garvita4/lightcube/CAD/productions/main bodyu.stl

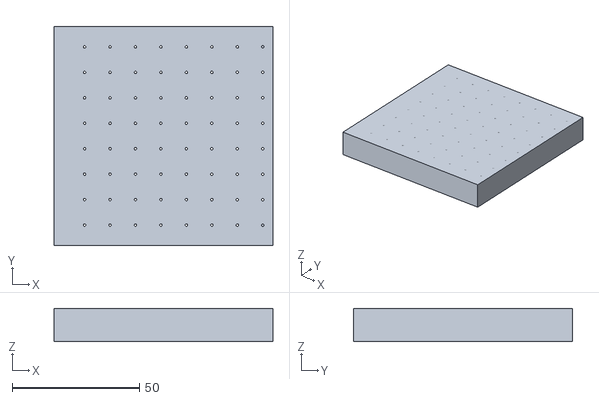
[picture p15: CAD file, 2026-11-04]
CAD/productions/main bodyu.stl
86.0 x 86.0 x 13.0
