garvita4/lightcube/CAD/design/final.stl

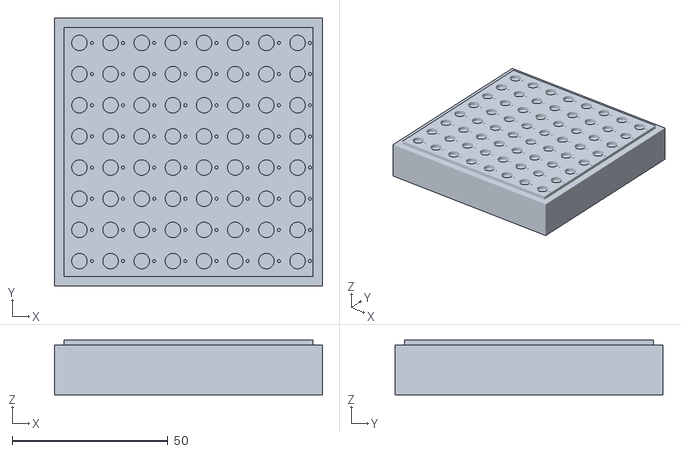
[picture p16: CAD file, 2026-11-04]
CAD/design/final.stl
86.0 x 86.0 x 17.5
