garvita4/lightcube/CAD/productions/holding plate.stl

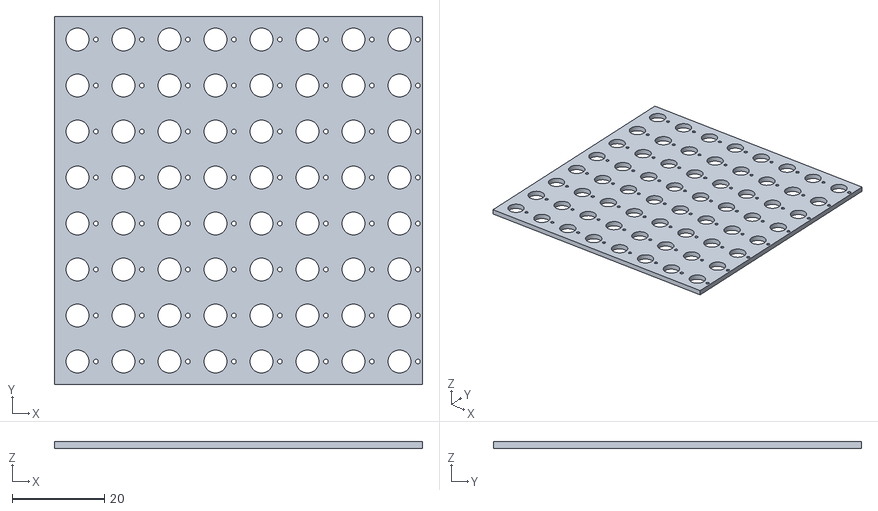
[picture p17: CAD file, 2026-11-04]
CAD/productions/holding plate.stl
80.0 x 80.0 x 1.50
