garvita4/lightcube/CAD/productions/cover.stl

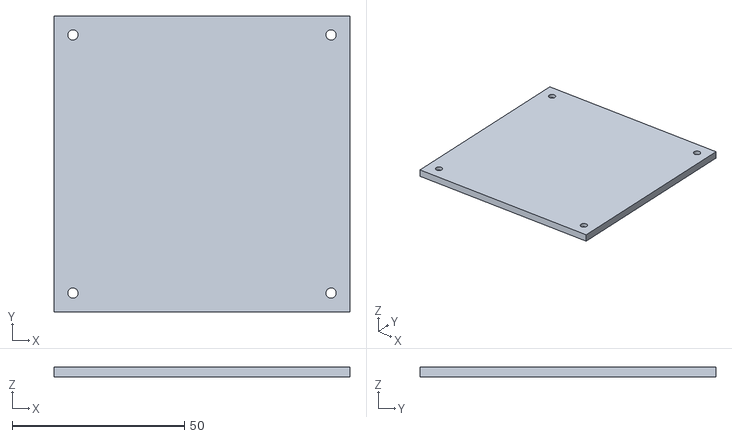
[picture p18: CAD file, 2026-11-04]
CAD/productions/cover.stl
86.0 x 86.0 x 3.00
