garvita4/lightcube/(list of files, cad)

Other CAD files:
CAD/design/final.f3d
