garvita4/lightcube/PCB/LED_L0.kicad_sch

## KiCad design PCB/LED_L0.kicad_sch (2026-11-04)

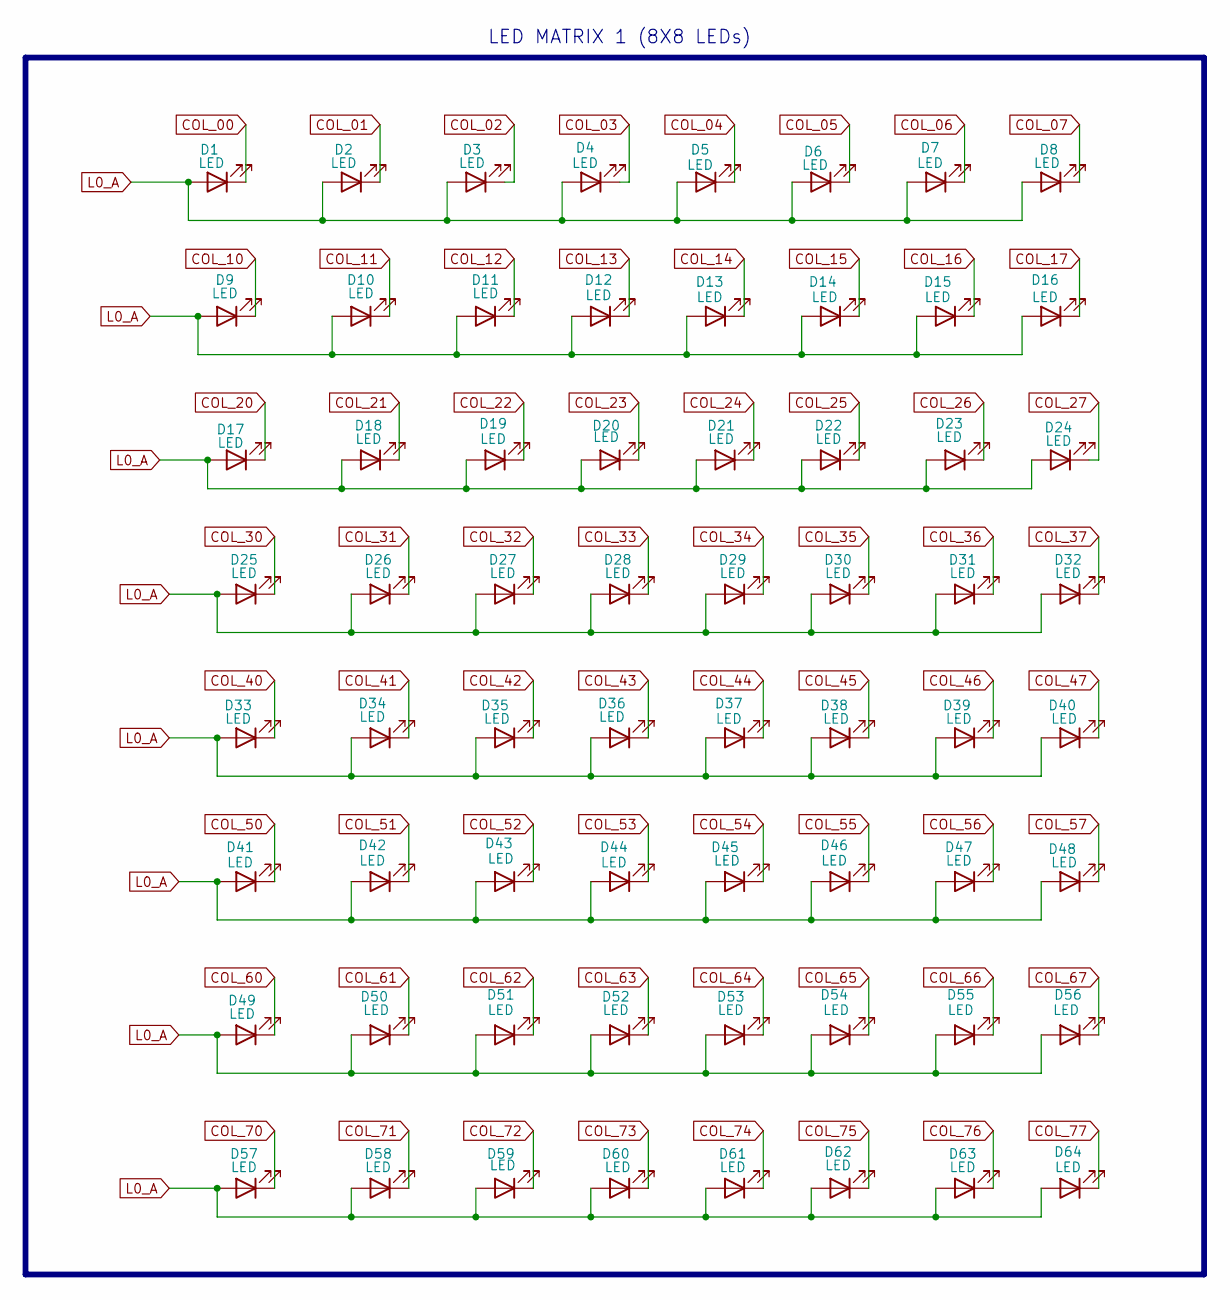
[picture p19: schematic LED_L0.kicad_sch]

Parts:
D1, D2, D3, D4, D5, D6, D7, D8, D9, D10, D11, D12, D13, D14, D15, D16, D17, D18, D19, D20, D21, D22, D23, D24, D25, D26, D27, D28, D29, D30, D31, D32, D33, D34, D35, D36, D37, D38, D39, D40, D41, D42, D43, D44, D45, D46, D47, D48, D49, D50, D51, D52, D53, D54, D55, D56, D57, D58, D59, D60, D61, D62, D63, D64: LED

Connections:
COL_00: D1.1 (K)
COL_01: D2.1 (K)
COL_02: D3.1 (K)
COL_03: D4.1 (K)
COL_04: D5.1 (K)
COL_05: D6.1 (K)
COL_06: D7.1 (K)
COL_07: D8.1 (K)
COL_10: D9.1 (K)
COL_11: D10.1 (K)
COL_12: D11.1 (K)
COL_13: D12.1 (K)
COL_14: D13.1 (K)
COL_15: D14.1 (K)
COL_16: D15.1 (K)
COL_17: D16.1 (K)
COL_20: D17.1 (K)
COL_21: D18.1 (K)
COL_22: D19.1 (K)
COL_23: D20.1 (K)
COL_24: D21.1 (K)
COL_25: D22.1 (K)
COL_26: D23.1 (K)
COL_27: D24.1 (K)
COL_30: D25.1 (K)
COL_31: D26.1 (K)
COL_32: D27.1 (K)
COL_33: D28.1 (K)
COL_34: D29.1 (K)
COL_35: D30.1 (K)
COL_36: D31.1 (K)
COL_37: D32.1 (K)
COL_40: D33.1 (K)
COL_41: D34.1 (K)
COL_42: D35.1 (K)
COL_43: D36.1 (K)
COL_44: D37.1 (K)
COL_45: D38.1 (K)
COL_46: D39.1 (K)
COL_47: D40.1 (K)
COL_50: D41.1 (K)
COL_51: D42.1 (K)
COL_52: D43.1 (K)
COL_53: D44.1 (K)
COL_54: D45.1 (K)
COL_55: D46.1 (K)
COL_56: D47.1 (K)
COL_57: D48.1 (K)
COL_60: D49.1 (K)
COL_61: D50.1 (K)
COL_62: D51.1 (K)
COL_63: D52.1 (K)
COL_64: D53.1 (K)
COL_65: D54.1 (K)
COL_66: D55.1 (K)
COL_67: D56.1 (K)
COL_70: D57.1 (K)
COL_71: D58.1 (K)
COL_72: D59.1 (K)
COL_73: D60.1 (K)
COL_74: D61.1 (K)
COL_75: D62.1 (K)
COL_76: D63.1 (K)
COL_77: D64.1 (K)
L0_A: D1.2 (A), D2.2 (A), D3.2 (A), D4.2 (A), D5.2 (A), D6.2 (A), D7.2 (A), D8.2 (A), D9.2 (A), D10.2 (A), D11.2 (A), D12.2 (A), D13.2 (A), D14.2 (A), D15.2 (A), D16.2 (A), D17.2 (A), D18.2 (A), D19.2 (A), D20.2 (A), D21.2 (A), D22.2 (A), D23.2 (A), D24.2 (A), D25.2 (A), D26.2 (A), D27.2 (A), D28.2 (A), D29.2 (A), D30.2 (A), D31.2 (A), D32.2 (A), D33.2 (A), D34.2 (A), D35.2 (A), D36.2 (A), D37.2 (A), D38.2 (A), D39.2 (A), D40.2 (A), D41.2 (A), D42.2 (A), D43.2 (A), D44.2 (A), D45.2 (A), D46.2 (A), D47.2 (A), D48.2 (A), D49.2 (A), D50.2 (A), D51.2 (A), D52.2 (A), D53.2 (A), D54.2 (A), D55.2 (A), D56.2 (A), D57.2 (A), D58.2 (A), D59.2 (A), D60.2 (A), D61.2 (A), D62.2 (A), D63.2 (A), D64.2 (A)

Notes on the sheet:
LED MATRIX 1 (8X8 LEDs)
