garvita4/lightcube/PCB/LED_L1.kicad_sch

## KiCad design PCB/LED_L1.kicad_sch (2026-11-11)

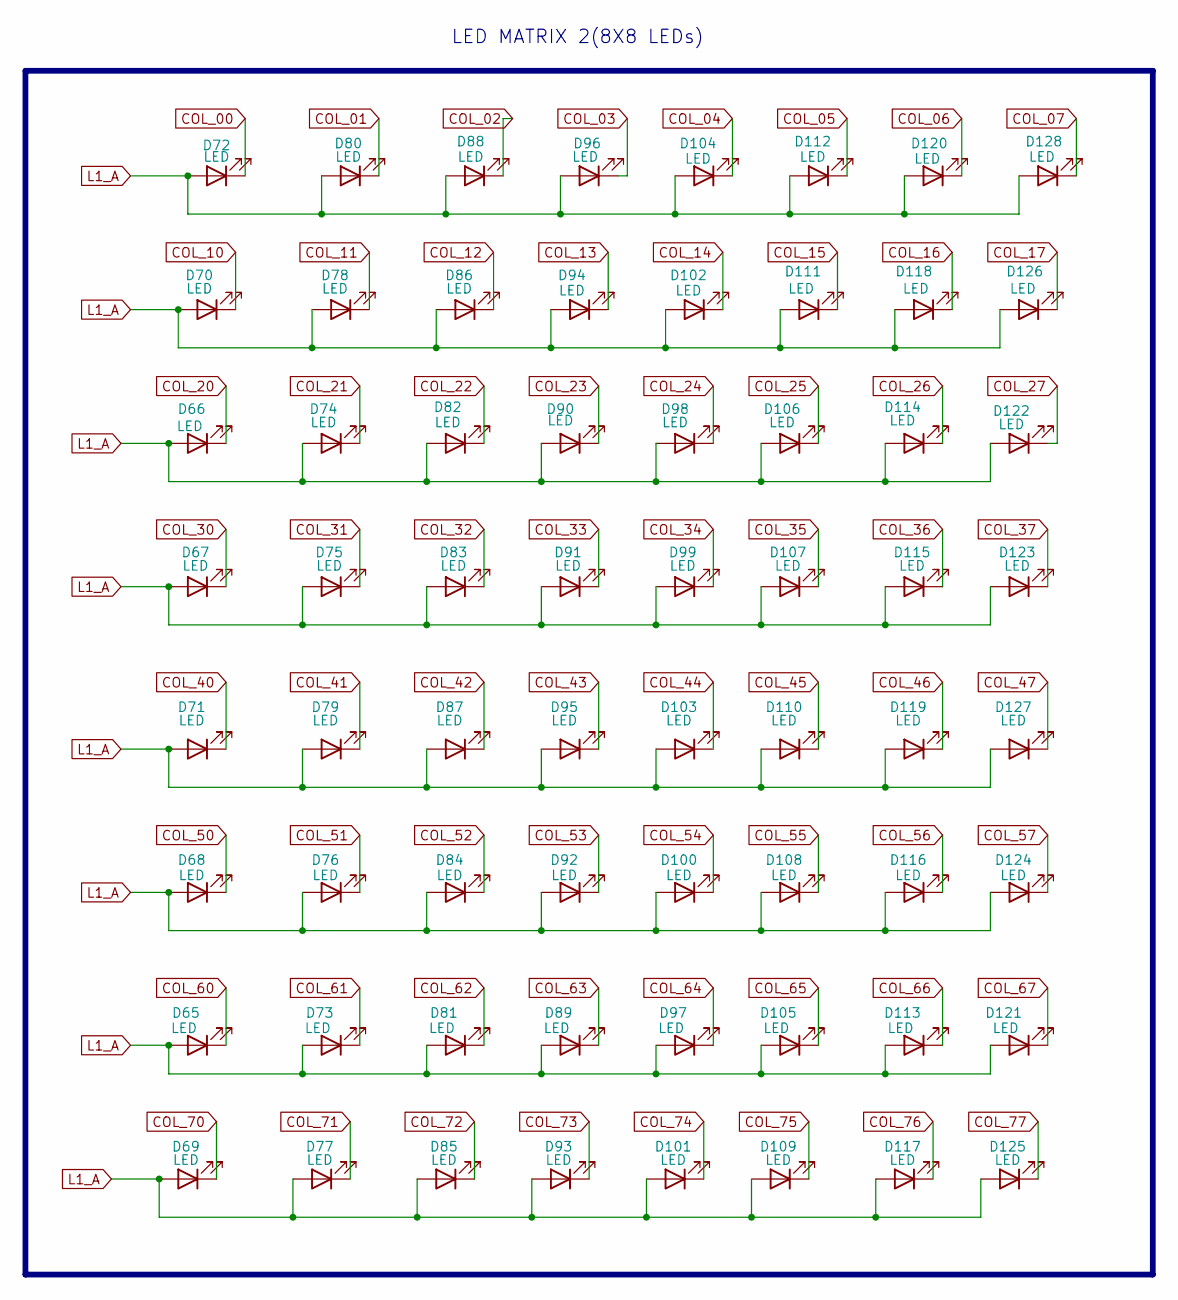
[picture p20: schematic LED_L1.kicad_sch]

Parts:
D65, D66, D67, D68, D69, D70, D71, D72, D73, D74, D75, D76, D77, D78, D79, D80, D81, D82, D83, D84, D85, D86, D87, D88, D89, D90, D91, D92, D93, D94, D95, D96, D97, D98, D99, D100, D101, D102, D103, D104, D105, D106, D107, D108, D109, D110, D111, D112, D113, D114, D115, D116, D117, D118, D119, D120, D121, D122, D123, D124, D125, D126, D127, D128: LED

Connections:
COL_00: D72.1 (K)
COL_01: D80.1 (K)
COL_02: D88.1 (K)
COL_03: D96.1 (K)
COL_04: D104.1 (K)
COL_05: D112.1 (K)
COL_06: D120.1 (K)
COL_07: D128.1 (K)
COL_10: D70.1 (K)
COL_11: D78.1 (K)
COL_12: D86.1 (K)
COL_13: D94.1 (K)
COL_14: D102.1 (K)
COL_15: D111.1 (K)
COL_16: D118.1 (K)
COL_17: D126.1 (K)
COL_20: D66.1 (K)
COL_21: D74.1 (K)
COL_22: D82.1 (K)
COL_23: D90.1 (K)
COL_24: D98.1 (K)
COL_25: D106.1 (K)
COL_26: D114.1 (K)
COL_27: D122.1 (K)
COL_30: D67.1 (K)
COL_31: D75.1 (K)
COL_32: D83.1 (K)
COL_33: D91.1 (K)
COL_34: D99.1 (K)
COL_35: D107.1 (K)
COL_36: D115.1 (K)
COL_37: D123.1 (K)
COL_40: D71.1 (K)
COL_41: D79.1 (K)
COL_42: D87.1 (K)
COL_43: D95.1 (K)
COL_44: D103.1 (K)
COL_45: D110.1 (K)
COL_46: D119.1 (K)
COL_47: D127.1 (K)
COL_50: D68.1 (K)
COL_51: D76.1 (K)
COL_52: D84.1 (K)
COL_53: D92.1 (K)
COL_54: D100.1 (K)
COL_55: D108.1 (K)
COL_56: D116.1 (K)
COL_57: D124.1 (K)
COL_60: D65.1 (K)
COL_61: D73.1 (K)
COL_62: D81.1 (K)
COL_63: D89.1 (K)
COL_64: D97.1 (K)
COL_65: D105.1 (K)
COL_66: D113.1 (K)
COL_67: D121.1 (K)
COL_70: D69.1 (K)
COL_71: D77.1 (K)
COL_72: D85.1 (K)
COL_73: D93.1 (K)
COL_74: D101.1 (K)
COL_75: D109.1 (K)
COL_76: D117.1 (K)
COL_77: D125.1 (K)
L1_A: D65.2 (A), D66.2 (A), D67.2 (A), D68.2 (A), D69.2 (A), D70.2 (A), D71.2 (A), D72.2 (A), D73.2 (A), D74.2 (A), D75.2 (A), D76.2 (A), D77.2 (A), D78.2 (A), D79.2 (A), D80.2 (A), D81.2 (A), D82.2 (A), D83.2 (A), D84.2 (A), D85.2 (A), D86.2 (A), D87.2 (A), D88.2 (A), D89.2 (A), D90.2 (A), D91.2 (A), D92.2 (A), D93.2 (A), D94.2 (A), D95.2 (A), D96.2 (A), D97.2 (A), D98.2 (A), D99.2 (A), D100.2 (A), D101.2 (A), D102.2 (A), D103.2 (A), D104.2 (A), D105.2 (A), D106.2 (A), D107.2 (A), D108.2 (A), D109.2 (A), D110.2 (A), D111.2 (A), D112.2 (A), D113.2 (A), D114.2 (A), D115.2 (A), D116.2 (A), D117.2 (A), D118.2 (A), D119.2 (A), D120.2 (A), D121.2 (A), D122.2 (A), D123.2 (A), D124.2 (A), D125.2 (A), D126.2 (A), D127.2 (A), D128.2 (A)

Notes on the sheet:
LED MATRIX 2(8X8 LEDs)
