garvita4/lightcube/PCB/LED_L2.kicad_sch

## KiCad design PCB/LED_L2.kicad_sch (2026-11-11)

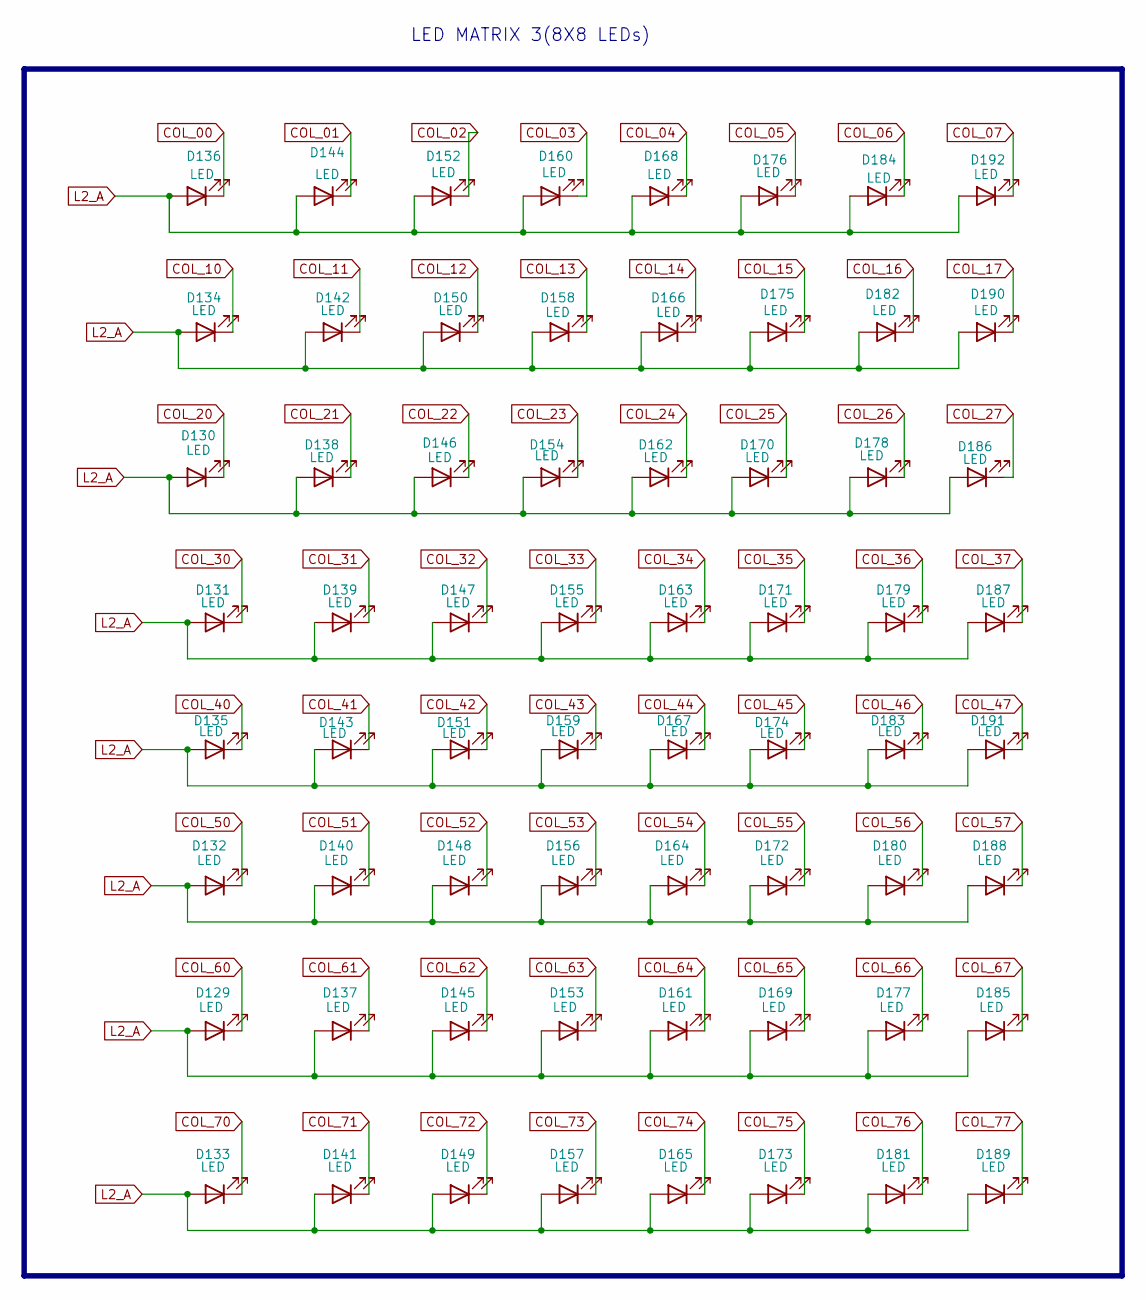
[picture p21: schematic LED_L2.kicad_sch]

Parts:
D129, D130, D131, D132, D133, D134, D135, D136, D137, D138, D139, D140, D141, D142, D143, D144, D145, D146, D147, D148, D149, D150, D151, D152, D153, D154, D155, D156, D157, D158, D159, D160, D161, D162, D163, D164, D165, D166, D167, D168, D169, D170, D171, D172, D173, D174, D175, D176, D177, D178, D179, D180, D181, D182, D183, D184, D185, D186, D187, D188, D189, D190, D191, D192: LED

Connections:
COL_00: D136.1 (K)
COL_01: D144.1 (K)
COL_02: D152.1 (K)
COL_03: D160.1 (K)
COL_04: D168.1 (K)
COL_05: D176.1 (K)
COL_06: D184.1 (K)
COL_07: D192.1 (K)
COL_10: D134.1 (K)
COL_11: D142.1 (K)
COL_12: D150.1 (K)
COL_13: D158.1 (K)
COL_14: D166.1 (K)
COL_15: D175.1 (K)
COL_16: D182.1 (K)
COL_17: D190.1 (K)
COL_20: D130.1 (K)
COL_21: D138.1 (K)
COL_22: D146.1 (K)
COL_23: D154.1 (K)
COL_24: D162.1 (K)
COL_25: D170.1 (K)
COL_26: D178.1 (K)
COL_27: D186.1 (K)
COL_30: D131.1 (K)
COL_31: D139.1 (K)
COL_32: D147.1 (K)
COL_33: D155.1 (K)
COL_34: D163.1 (K)
COL_35: D171.1 (K)
COL_36: D179.1 (K)
COL_37: D187.1 (K)
COL_40: D135.1 (K)
COL_41: D143.1 (K)
COL_42: D151.1 (K)
COL_43: D159.1 (K)
COL_44: D167.1 (K)
COL_45: D174.1 (K)
COL_46: D183.1 (K)
COL_47: D191.1 (K)
COL_50: D132.1 (K)
COL_51: D140.1 (K)
COL_52: D148.1 (K)
COL_53: D156.1 (K)
COL_54: D164.1 (K)
COL_55: D172.1 (K)
COL_56: D180.1 (K)
COL_57: D188.1 (K)
COL_60: D129.1 (K)
COL_61: D137.1 (K)
COL_62: D145.1 (K)
COL_63: D153.1 (K)
COL_64: D161.1 (K)
COL_65: D169.1 (K)
COL_66: D177.1 (K)
COL_67: D185.1 (K)
COL_70: D133.1 (K)
COL_71: D141.1 (K)
COL_72: D149.1 (K)
COL_73: D157.1 (K)
COL_74: D165.1 (K)
COL_75: D173.1 (K)
COL_76: D181.1 (K)
COL_77: D189.1 (K)
L2_A: D129.2 (A), D130.2 (A), D131.2 (A), D132.2 (A), D133.2 (A), D134.2 (A), D135.2 (A), D136.2 (A), D137.2 (A), D138.2 (A), D139.2 (A), D140.2 (A), D141.2 (A), D142.2 (A), D143.2 (A), D144.2 (A), D145.2 (A), D146.2 (A), D147.2 (A), D148.2 (A), D149.2 (A), D150.2 (A), D151.2 (A), D152.2 (A), D153.2 (A), D154.2 (A), D155.2 (A), D156.2 (A), D157.2 (A), D158.2 (A), D159.2 (A), D160.2 (A), D161.2 (A), D162.2 (A), D163.2 (A), D164.2 (A), D165.2 (A), D166.2 (A), D167.2 (A), D168.2 (A), D169.2 (A), D170.2 (A), D171.2 (A), D172.2 (A), D173.2 (A), D174.2 (A), D175.2 (A), D176.2 (A), D177.2 (A), D178.2 (A), D179.2 (A), D180.2 (A), D181.2 (A), D182.2 (A), D183.2 (A), D184.2 (A), D185.2 (A), D186.2 (A), D187.2 (A), D188.2 (A), D189.2 (A), D190.2 (A), D191.2 (A), D192.2 (A)

Notes on the sheet:
LED MATRIX 3(8X8 LEDs)
