garvita4/lightcube/PCB/LED_L3.kicad_sch

## KiCad design PCB/LED_L3.kicad_sch (2026-11-11)

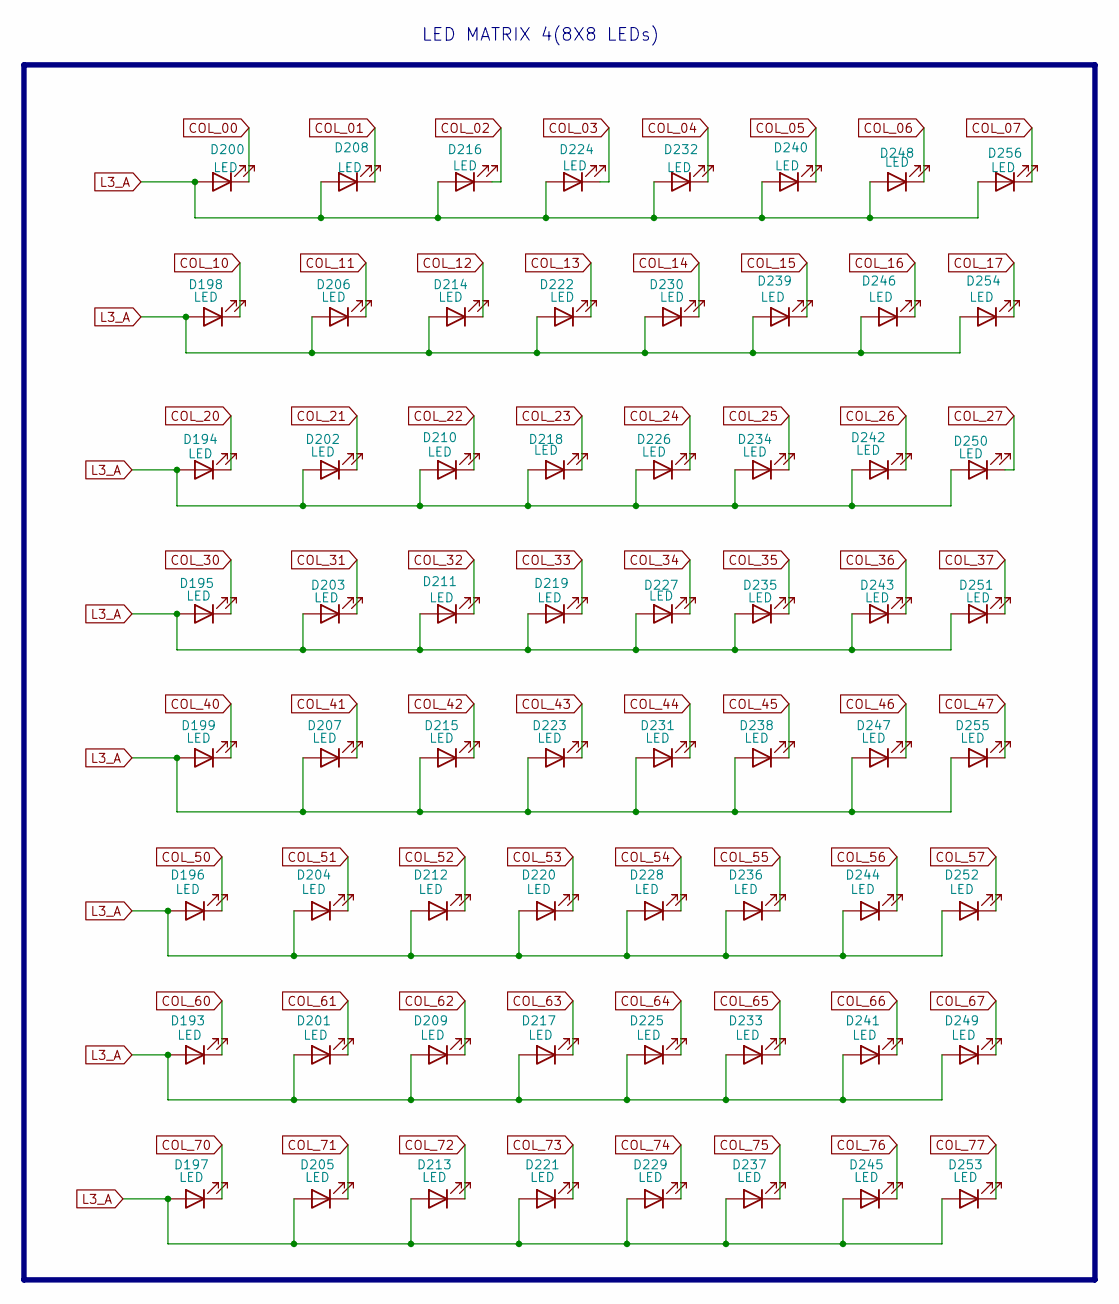
[picture p22: schematic LED_L3.kicad_sch]

Parts:
D193, D194, D195, D196, D197, D198, D199, D200, D201, D202, D203, D204, D205, D206, D207, D208, D209, D210, D211, D212, D213, D214, D215, D216, D217, D218, D219, D220, D221, D222, D223, D224, D225, D226, D227, D228, D229, D230, D231, D232, D233, D234, D235, D236, D237, D238, D239, D240, D241, D242, D243, D244, D245, D246, D247, D248, D249, D250, D251, D252, D253, D254, D255, D256: LED

Connections:
COL_00: D200.1 (K)
COL_01: D208.1 (K)
COL_02: D216.1 (K)
COL_03: D224.1 (K)
COL_04: D232.1 (K)
COL_05: D240.1 (K)
COL_06: D248.1 (K)
COL_07: D256.1 (K)
COL_10: D198.1 (K)
COL_11: D206.1 (K)
COL_12: D214.1 (K)
COL_13: D222.1 (K)
COL_14: D230.1 (K)
COL_15: D239.1 (K)
COL_16: D246.1 (K)
COL_17: D254.1 (K)
COL_20: D194.1 (K)
COL_21: D202.1 (K)
COL_22: D210.1 (K)
COL_23: D218.1 (K)
COL_24: D226.1 (K)
COL_25: D234.1 (K)
COL_26: D242.1 (K)
COL_27: D250.1 (K)
COL_30: D195.1 (K)
COL_31: D203.1 (K)
COL_32: D211.1 (K)
COL_33: D219.1 (K)
COL_34: D227.1 (K)
COL_35: D235.1 (K)
COL_36: D243.1 (K)
COL_37: D251.1 (K)
COL_40: D199.1 (K)
COL_41: D207.1 (K)
COL_42: D215.1 (K)
COL_43: D223.1 (K)
COL_44: D231.1 (K)
COL_45: D238.1 (K)
COL_46: D247.1 (K)
COL_47: D255.1 (K)
COL_50: D196.1 (K)
COL_51: D204.1 (K)
COL_52: D212.1 (K)
COL_53: D220.1 (K)
COL_54: D228.1 (K)
COL_55: D236.1 (K)
COL_56: D244.1 (K)
COL_57: D252.1 (K)
COL_60: D193.1 (K)
COL_61: D201.1 (K)
COL_62: D209.1 (K)
COL_63: D217.1 (K)
COL_64: D225.1 (K)
COL_65: D233.1 (K)
COL_66: D241.1 (K)
COL_67: D249.1 (K)
COL_70: D197.1 (K)
COL_71: D205.1 (K)
COL_72: D213.1 (K)
COL_73: D221.1 (K)
COL_74: D229.1 (K)
COL_75: D237.1 (K)
COL_76: D245.1 (K)
COL_77: D253.1 (K)
L3_A: D193.2 (A), D194.2 (A), D195.2 (A), D196.2 (A), D197.2 (A), D198.2 (A), D199.2 (A), D200.2 (A), D201.2 (A), D202.2 (A), D203.2 (A), D204.2 (A), D205.2 (A), D206.2 (A), D207.2 (A), D208.2 (A), D209.2 (A), D210.2 (A), D211.2 (A), D212.2 (A), D213.2 (A), D214.2 (A), D215.2 (A), D216.2 (A), D217.2 (A), D218.2 (A), D219.2 (A), D220.2 (A), D221.2 (A), D222.2 (A), D223.2 (A), D224.2 (A), D225.2 (A), D226.2 (A), D227.2 (A), D228.2 (A), D229.2 (A), D230.2 (A), D231.2 (A), D232.2 (A), D233.2 (A), D234.2 (A), D235.2 (A), D236.2 (A), D237.2 (A), D238.2 (A), D239.2 (A), D240.2 (A), D241.2 (A), D242.2 (A), D243.2 (A), D244.2 (A), D245.2 (A), D246.2 (A), D247.2 (A), D248.2 (A), D249.2 (A), D250.2 (A), D251.2 (A), D252.2 (A), D253.2 (A), D254.2 (A), D255.2 (A), D256.2 (A)

Notes on the sheet:
LED MATRIX 4(8X8 LEDs)
