garvita4/lightcube/PCB/LED_L4.kicad_sch

## KiCad design PCB/LED_L4.kicad_sch (2026-11-11)

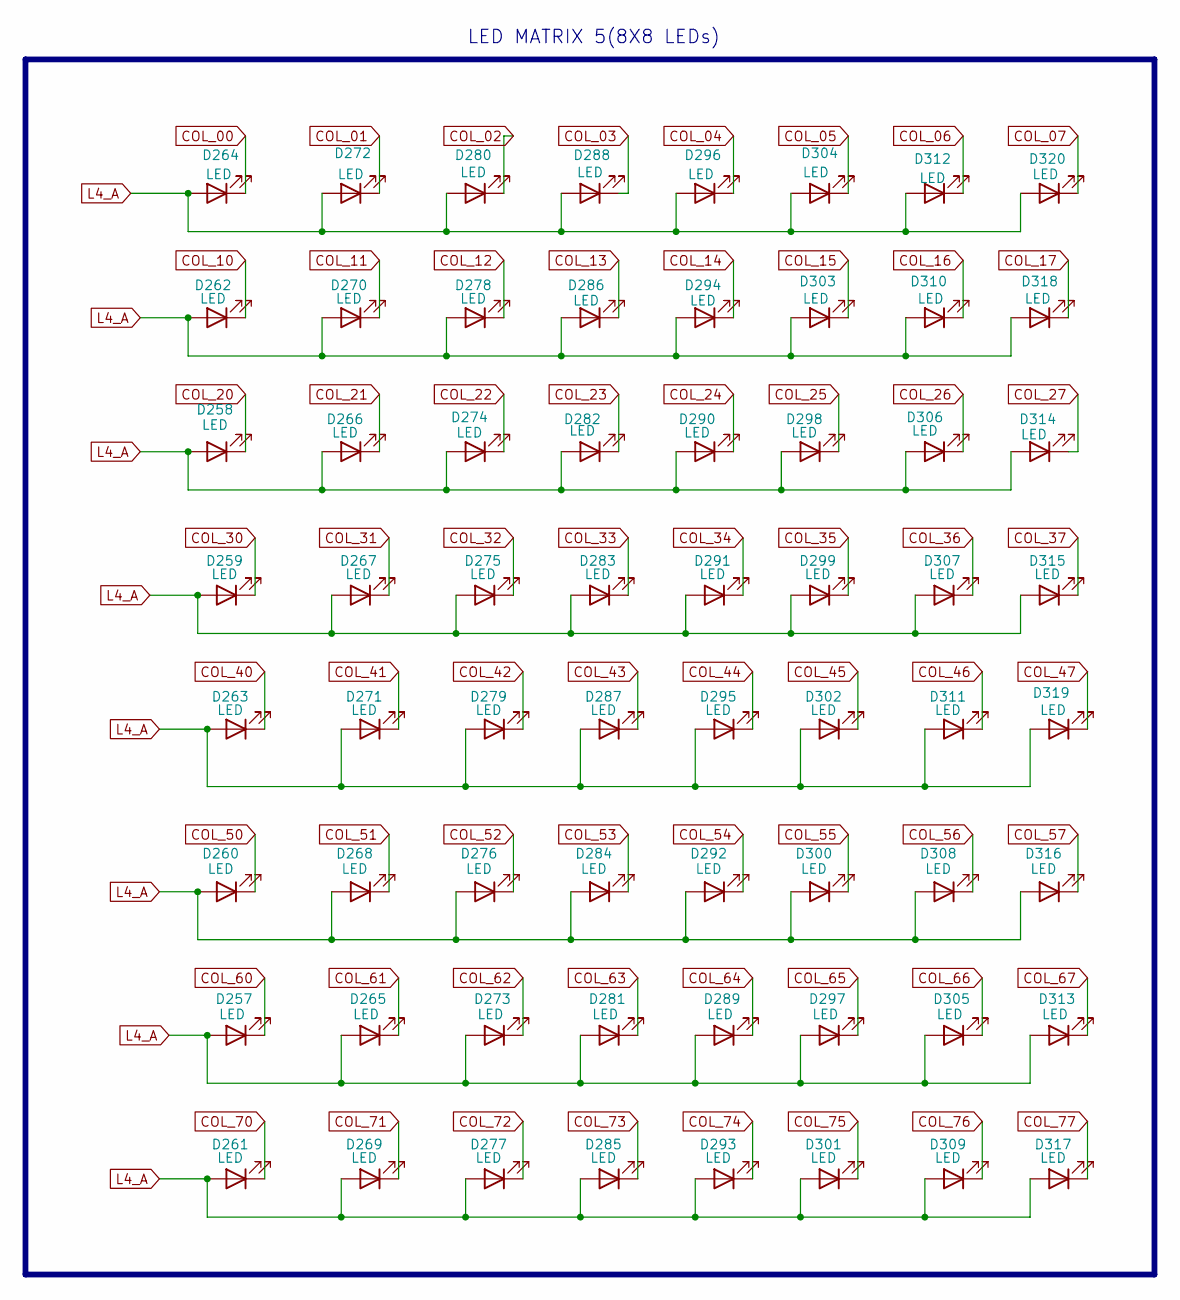
[picture p23: schematic LED_L4.kicad_sch]

Parts:
D257, D258, D259, D260, D261, D262, D263, D264, D265, D266, D267, D268, D269, D270, D271, D272, D273, D274, D275, D276, D277, D278, D279, D280, D281, D282, D283, D284, D285, D286, D287, D288, D289, D290, D291, D292, D293, D294, D295, D296, D297, D298, D299, D300, D301, D302, D303, D304, D305, D306, D307, D308, D309, D310, D311, D312, D313, D314, D315, D316, D317, D318, D319, D320: LED

Connections:
COL_00: D264.1 (K)
COL_01: D272.1 (K)
COL_02: D280.1 (K)
COL_03: D288.1 (K)
COL_04: D296.1 (K)
COL_05: D304.1 (K)
COL_06: D312.1 (K)
COL_07: D320.1 (K)
COL_10: D262.1 (K)
COL_11: D270.1 (K)
COL_12: D278.1 (K)
COL_13: D286.1 (K)
COL_14: D294.1 (K)
COL_15: D303.1 (K)
COL_16: D310.1 (K)
COL_17: D318.1 (K)
COL_20: D258.1 (K)
COL_21: D266.1 (K)
COL_22: D274.1 (K)
COL_23: D282.1 (K)
COL_24: D290.1 (K)
COL_25: D298.1 (K)
COL_26: D306.1 (K)
COL_27: D314.1 (K)
COL_30: D259.1 (K)
COL_31: D267.1 (K)
COL_32: D275.1 (K)
COL_33: D283.1 (K)
COL_34: D291.1 (K)
COL_35: D299.1 (K)
COL_36: D307.1 (K)
COL_37: D315.1 (K)
COL_40: D263.1 (K)
COL_41: D271.1 (K)
COL_42: D279.1 (K)
COL_43: D287.1 (K)
COL_44: D295.1 (K)
COL_45: D302.1 (K)
COL_46: D311.1 (K)
COL_47: D319.1 (K)
COL_50: D260.1 (K)
COL_51: D268.1 (K)
COL_52: D276.1 (K)
COL_53: D284.1 (K)
COL_54: D292.1 (K)
COL_55: D300.1 (K)
COL_56: D308.1 (K)
COL_57: D316.1 (K)
COL_60: D257.1 (K)
COL_61: D265.1 (K)
COL_62: D273.1 (K)
COL_63: D281.1 (K)
COL_64: D289.1 (K)
COL_65: D297.1 (K)
COL_66: D305.1 (K)
COL_67: D313.1 (K)
COL_70: D261.1 (K)
COL_71: D269.1 (K)
COL_72: D277.1 (K)
COL_73: D285.1 (K)
COL_74: D293.1 (K)
COL_75: D301.1 (K)
COL_76: D309.1 (K)
COL_77: D317.1 (K)
L4_A: D257.2 (A), D258.2 (A), D259.2 (A), D260.2 (A), D261.2 (A), D262.2 (A), D263.2 (A), D264.2 (A), D265.2 (A), D266.2 (A), D267.2 (A), D268.2 (A), D269.2 (A), D270.2 (A), D271.2 (A), D272.2 (A), D273.2 (A), D274.2 (A), D275.2 (A), D276.2 (A), D277.2 (A), D278.2 (A), D279.2 (A), D280.2 (A), D281.2 (A), D282.2 (A), D283.2 (A), D284.2 (A), D285.2 (A), D286.2 (A), D287.2 (A), D288.2 (A), D289.2 (A), D290.2 (A), D291.2 (A), D292.2 (A), D293.2 (A), D294.2 (A), D295.2 (A), D296.2 (A), D297.2 (A), D298.2 (A), D299.2 (A), D300.2 (A), D301.2 (A), D302.2 (A), D303.2 (A), D304.2 (A), D305.2 (A), D306.2 (A), D307.2 (A), D308.2 (A), D309.2 (A), D310.2 (A), D311.2 (A), D312.2 (A), D313.2 (A), D314.2 (A), D315.2 (A), D316.2 (A), D317.2 (A), D318.2 (A), D319.2 (A), D320.2 (A)

Notes on the sheet:
LED MATRIX 5(8X8 LEDs)
