garvita4/lightcube/PCB/LED_L5.kicad_sch

## KiCad design PCB/LED_L5.kicad_sch (2026-11-11)

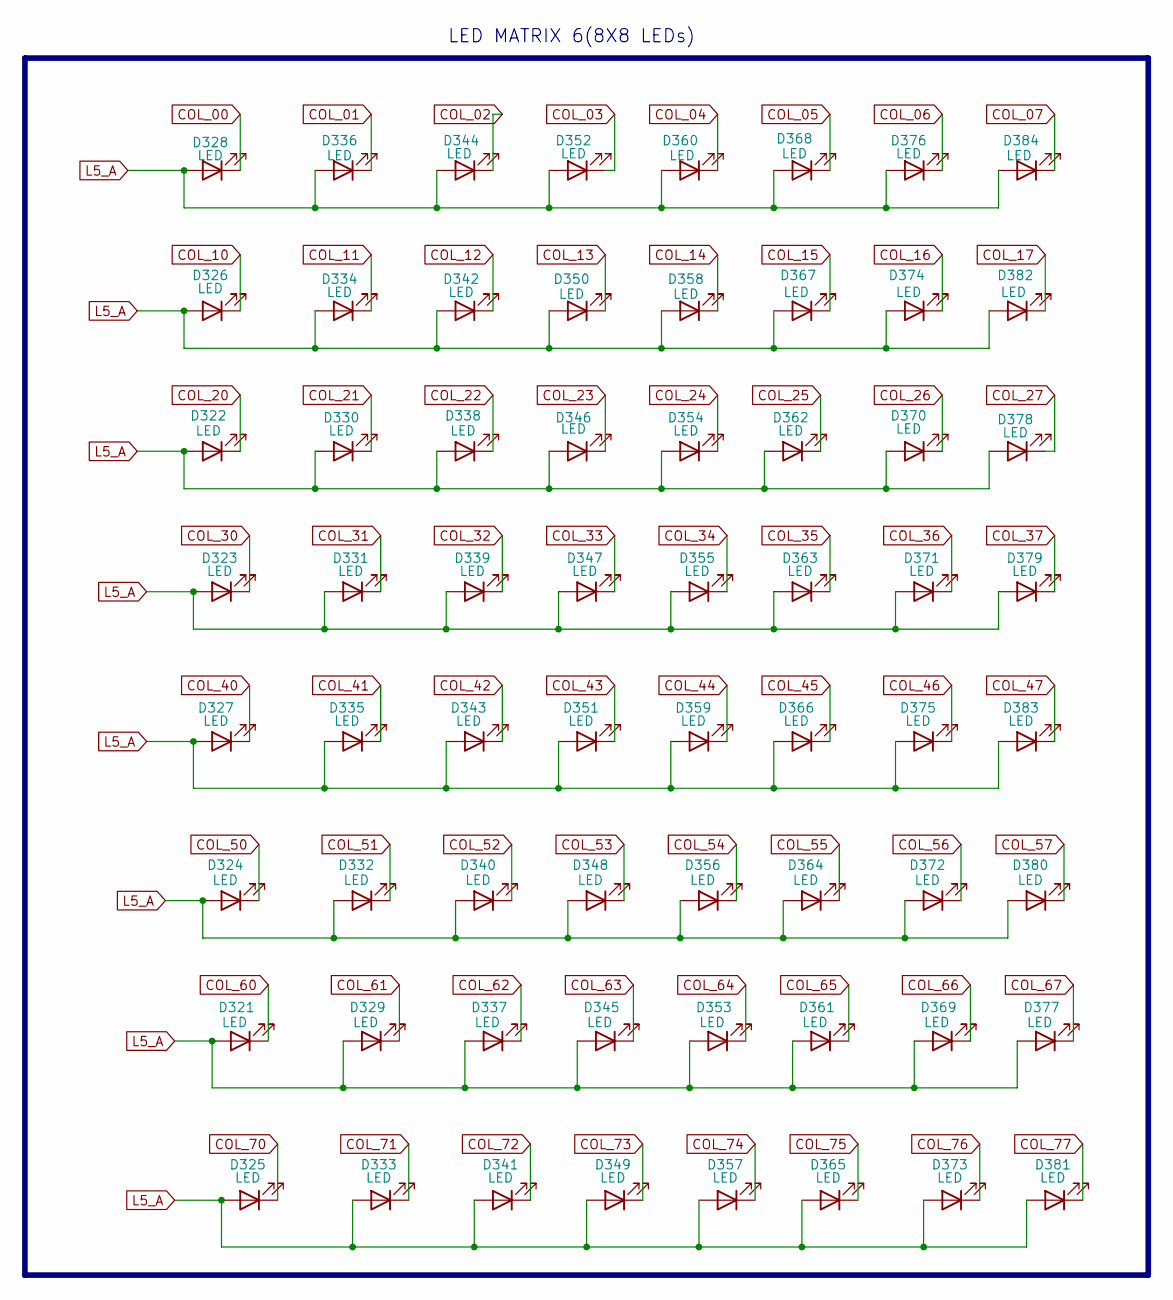
[picture p24: schematic LED_L5.kicad_sch]

Parts:
D321, D322, D323, D324, D325, D326, D327, D328, D329, D330, D331, D332, D333, D334, D335, D336, D337, D338, D339, D340, D341, D342, D343, D344, D345, D346, D347, D348, D349, D350, D351, D352, D353, D354, D355, D356, D357, D358, D359, D360, D361, D362, D363, D364, D365, D366, D367, D368, D369, D370, D371, D372, D373, D374, D375, D376, D377, D378, D379, D380, D381, D382, D383, D384: LED

Connections:
COL_00: D328.1 (K)
COL_01: D336.1 (K)
COL_02: D344.1 (K)
COL_03: D352.1 (K)
COL_04: D360.1 (K)
COL_05: D368.1 (K)
COL_06: D376.1 (K)
COL_07: D384.1 (K)
COL_10: D326.1 (K)
COL_11: D334.1 (K)
COL_12: D342.1 (K)
COL_13: D350.1 (K)
COL_14: D358.1 (K)
COL_15: D367.1 (K)
COL_16: D374.1 (K)
COL_17: D382.1 (K)
COL_20: D322.1 (K)
COL_21: D330.1 (K)
COL_22: D338.1 (K)
COL_23: D346.1 (K)
COL_24: D354.1 (K)
COL_25: D362.1 (K)
COL_26: D370.1 (K)
COL_27: D378.1 (K)
COL_30: D323.1 (K)
COL_31: D331.1 (K)
COL_32: D339.1 (K)
COL_33: D347.1 (K)
COL_34: D355.1 (K)
COL_35: D363.1 (K)
COL_36: D371.1 (K)
COL_37: D379.1 (K)
COL_40: D327.1 (K)
COL_41: D335.1 (K)
COL_42: D343.1 (K)
COL_43: D351.1 (K)
COL_44: D359.1 (K)
COL_45: D366.1 (K)
COL_46: D375.1 (K)
COL_47: D383.1 (K)
COL_50: D324.1 (K)
COL_51: D332.1 (K)
COL_52: D340.1 (K)
COL_53: D348.1 (K)
COL_54: D356.1 (K)
COL_55: D364.1 (K)
COL_56: D372.1 (K)
COL_57: D380.1 (K)
COL_60: D321.1 (K)
COL_61: D329.1 (K)
COL_62: D337.1 (K)
COL_63: D345.1 (K)
COL_64: D353.1 (K)
COL_65: D361.1 (K)
COL_66: D369.1 (K)
COL_67: D377.1 (K)
COL_70: D325.1 (K)
COL_71: D333.1 (K)
COL_72: D341.1 (K)
COL_73: D349.1 (K)
COL_74: D357.1 (K)
COL_75: D365.1 (K)
COL_76: D373.1 (K)
COL_77: D381.1 (K)
L5_A: D321.2 (A), D322.2 (A), D323.2 (A), D324.2 (A), D325.2 (A), D326.2 (A), D327.2 (A), D328.2 (A), D329.2 (A), D330.2 (A), D331.2 (A), D332.2 (A), D333.2 (A), D334.2 (A), D335.2 (A), D336.2 (A), D337.2 (A), D338.2 (A), D339.2 (A), D340.2 (A), D341.2 (A), D342.2 (A), D343.2 (A), D344.2 (A), D345.2 (A), D346.2 (A), D347.2 (A), D348.2 (A), D349.2 (A), D350.2 (A), D351.2 (A), D352.2 (A), D353.2 (A), D354.2 (A), D355.2 (A), D356.2 (A), D357.2 (A), D358.2 (A), D359.2 (A), D360.2 (A), D361.2 (A), D362.2 (A), D363.2 (A), D364.2 (A), D365.2 (A), D366.2 (A), D367.2 (A), D368.2 (A), D369.2 (A), D370.2 (A), D371.2 (A), D372.2 (A), D373.2 (A), D374.2 (A), D375.2 (A), D376.2 (A), D377.2 (A), D378.2 (A), D379.2 (A), D380.2 (A), D381.2 (A), D382.2 (A), D383.2 (A), D384.2 (A)

Notes on the sheet:
LED MATRIX 6(8X8 LEDs)
