garvita4/lightcube/PCB/LED_L6.kicad_sch

## KiCad design PCB/LED_L6.kicad_sch (2026-11-11)

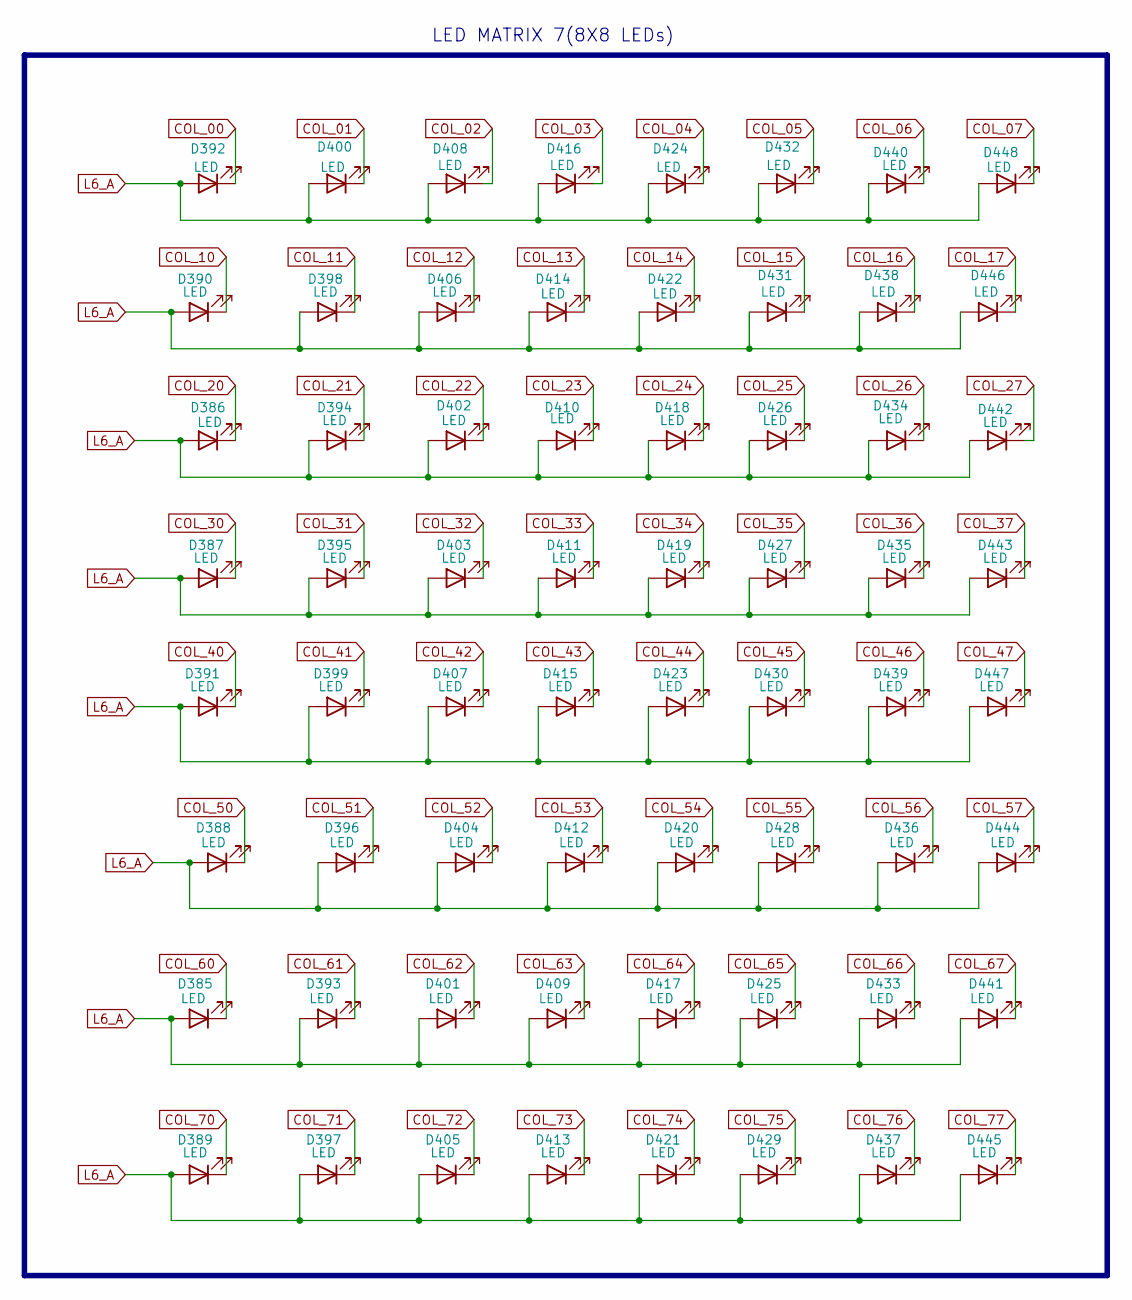
[picture p25: schematic LED_L6.kicad_sch]

Parts:
D385, D386, D387, D388, D389, D390, D391, D392, D393, D394, D395, D396, D397, D398, D399, D400, D401, D402, D403, D404, D405, D406, D407, D408, D409, D410, D411, D412, D413, D414, D415, D416, D417, D418, D419, D420, D421, D422, D423, D424, D425, D426, D427, D428, D429, D430, D431, D432, D433, D434, D435, D436, D437, D438, D439, D440, D441, D442, D443, D444, D445, D446, D447, D448: LED

Connections:
COL_00: D392.1 (K)
COL_01: D400.1 (K)
COL_02: D408.1 (K)
COL_03: D416.1 (K)
COL_04: D424.1 (K)
COL_05: D432.1 (K)
COL_06: D440.1 (K)
COL_07: D448.1 (K)
COL_10: D390.1 (K)
COL_11: D398.1 (K)
COL_12: D406.1 (K)
COL_13: D414.1 (K)
COL_14: D422.1 (K)
COL_15: D431.1 (K)
COL_16: D438.1 (K)
COL_17: D446.1 (K)
COL_20: D386.1 (K)
COL_21: D394.1 (K)
COL_22: D402.1 (K)
COL_23: D410.1 (K)
COL_24: D418.1 (K)
COL_25: D426.1 (K)
COL_26: D434.1 (K)
COL_27: D442.1 (K)
COL_30: D387.1 (K)
COL_31: D395.1 (K)
COL_32: D403.1 (K)
COL_33: D411.1 (K)
COL_34: D419.1 (K)
COL_35: D427.1 (K)
COL_36: D435.1 (K)
COL_37: D443.1 (K)
COL_40: D391.1 (K)
COL_41: D399.1 (K)
COL_42: D407.1 (K)
COL_43: D415.1 (K)
COL_44: D423.1 (K)
COL_45: D430.1 (K)
COL_46: D439.1 (K)
COL_47: D447.1 (K)
COL_50: D388.1 (K)
COL_51: D396.1 (K)
COL_52: D404.1 (K)
COL_53: D412.1 (K)
COL_54: D420.1 (K)
COL_55: D428.1 (K)
COL_56: D436.1 (K)
COL_57: D444.1 (K)
COL_60: D385.1 (K)
COL_61: D393.1 (K)
COL_62: D401.1 (K)
COL_63: D409.1 (K)
COL_64: D417.1 (K)
COL_65: D425.1 (K)
COL_66: D433.1 (K)
COL_67: D441.1 (K)
COL_70: D389.1 (K)
COL_71: D397.1 (K)
COL_72: D405.1 (K)
COL_73: D413.1 (K)
COL_74: D421.1 (K)
COL_75: D429.1 (K)
COL_76: D437.1 (K)
COL_77: D445.1 (K)
L6_A: D385.2 (A), D386.2 (A), D387.2 (A), D388.2 (A), D389.2 (A), D390.2 (A), D391.2 (A), D392.2 (A), D393.2 (A), D394.2 (A), D395.2 (A), D396.2 (A), D397.2 (A), D398.2 (A), D399.2 (A), D400.2 (A), D401.2 (A), D402.2 (A), D403.2 (A), D404.2 (A), D405.2 (A), D406.2 (A), D407.2 (A), D408.2 (A), D409.2 (A), D410.2 (A), D411.2 (A), D412.2 (A), D413.2 (A), D414.2 (A), D415.2 (A), D416.2 (A), D417.2 (A), D418.2 (A), D419.2 (A), D420.2 (A), D421.2 (A), D422.2 (A), D423.2 (A), D424.2 (A), D425.2 (A), D426.2 (A), D427.2 (A), D428.2 (A), D429.2 (A), D430.2 (A), D431.2 (A), D432.2 (A), D433.2 (A), D434.2 (A), D435.2 (A), D436.2 (A), D437.2 (A), D438.2 (A), D439.2 (A), D440.2 (A), D441.2 (A), D442.2 (A), D443.2 (A), D444.2 (A), D445.2 (A), D446.2 (A), D447.2 (A), D448.2 (A)

Notes on the sheet:
LED MATRIX 7(8X8 LEDs)
