garvita4/lightcube/PCB/LED_L7.kicad_sch

## KiCad design PCB/LED_L7.kicad_sch (2026-11-11)

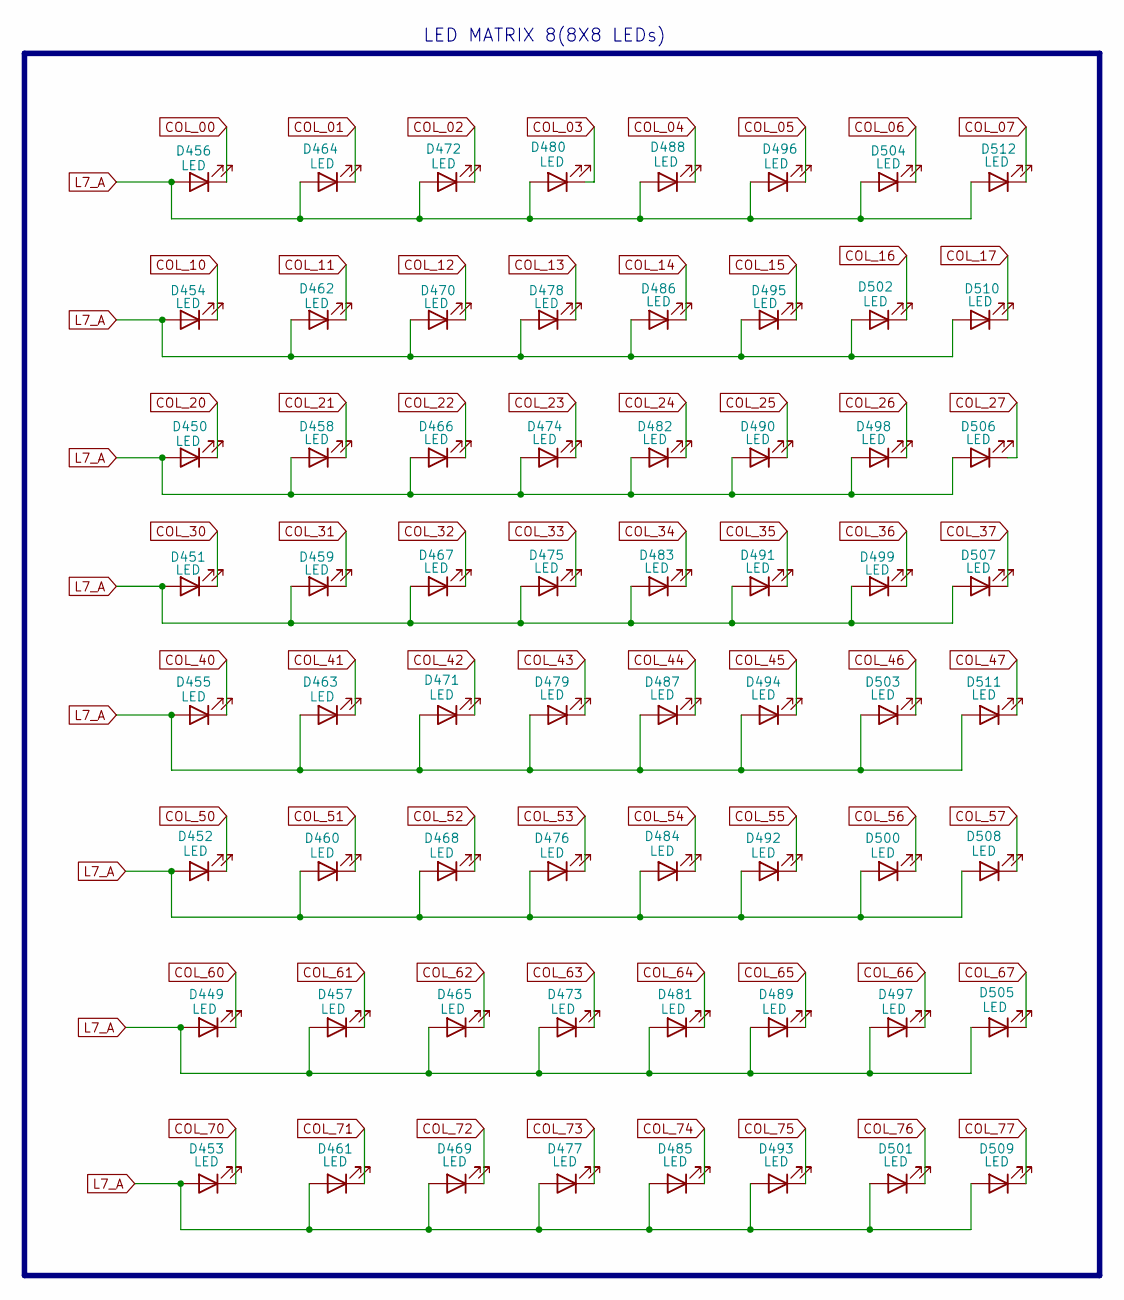
[picture p26: schematic LED_L7.kicad_sch]

Parts:
D449, D450, D451, D452, D453, D454, D455, D456, D457, D458, D459, D460, D461, D462, D463, D464, D465, D466, D467, D468, D469, D470, D471, D472, D473, D474, D475, D476, D477, D478, D479, D480, D481, D482, D483, D484, D485, D486, D487, D488, D489, D490, D491, D492, D493, D494, D495, D496, D497, D498, D499, D500, D501, D502, D503, D504, D505, D506, D507, D508, D509, D510, D511, D512: LED

Connections:
COL_00: D456.1 (K)
COL_01: D464.1 (K)
COL_02: D472.1 (K)
COL_03: D480.1 (K)
COL_04: D488.1 (K)
COL_05: D496.1 (K)
COL_06: D504.1 (K)
COL_07: D512.1 (K)
COL_10: D454.1 (K)
COL_11: D462.1 (K)
COL_12: D470.1 (K)
COL_13: D478.1 (K)
COL_14: D486.1 (K)
COL_15: D495.1 (K)
COL_16: D502.1 (K)
COL_17: D510.1 (K)
COL_20: D450.1 (K)
COL_21: D458.1 (K)
COL_22: D466.1 (K)
COL_23: D474.1 (K)
COL_24: D482.1 (K)
COL_25: D490.1 (K)
COL_26: D498.1 (K)
COL_27: D506.1 (K)
COL_30: D451.1 (K)
COL_31: D459.1 (K)
COL_32: D467.1 (K)
COL_33: D475.1 (K)
COL_34: D483.1 (K)
COL_35: D491.1 (K)
COL_36: D499.1 (K)
COL_37: D507.1 (K)
COL_40: D455.1 (K)
COL_41: D463.1 (K)
COL_42: D471.1 (K)
COL_43: D479.1 (K)
COL_44: D487.1 (K)
COL_45: D494.1 (K)
COL_46: D503.1 (K)
COL_47: D511.1 (K)
COL_50: D452.1 (K)
COL_51: D460.1 (K)
COL_52: D468.1 (K)
COL_53: D476.1 (K)
COL_54: D484.1 (K)
COL_55: D492.1 (K)
COL_56: D500.1 (K)
COL_57: D508.1 (K)
COL_60: D449.1 (K)
COL_61: D457.1 (K)
COL_62: D465.1 (K)
COL_63: D473.1 (K)
COL_64: D481.1 (K)
COL_65: D489.1 (K)
COL_66: D497.1 (K)
COL_67: D505.1 (K)
COL_70: D453.1 (K)
COL_71: D461.1 (K)
COL_72: D469.1 (K)
COL_73: D477.1 (K)
COL_74: D485.1 (K)
COL_75: D493.1 (K)
COL_76: D501.1 (K)
COL_77: D509.1 (K)
L7_A: D449.2 (A), D450.2 (A), D451.2 (A), D452.2 (A), D453.2 (A), D454.2 (A), D455.2 (A), D456.2 (A), D457.2 (A), D458.2 (A), D459.2 (A), D460.2 (A), D461.2 (A), D462.2 (A), D463.2 (A), D464.2 (A), D465.2 (A), D466.2 (A), D467.2 (A), D468.2 (A), D469.2 (A), D470.2 (A), D471.2 (A), D472.2 (A), D473.2 (A), D474.2 (A), D475.2 (A), D476.2 (A), D477.2 (A), D478.2 (A), D479.2 (A), D480.2 (A), D481.2 (A), D482.2 (A), D483.2 (A), D484.2 (A), D485.2 (A), D486.2 (A), D487.2 (A), D488.2 (A), D489.2 (A), D490.2 (A), D491.2 (A), D492.2 (A), D493.2 (A), D494.2 (A), D495.2 (A), D496.2 (A), D497.2 (A), D498.2 (A), D499.2 (A), D500.2 (A), D501.2 (A), D502.2 (A), D503.2 (A), D504.2 (A), D505.2 (A), D506.2 (A), D507.2 (A), D508.2 (A), D509.2 (A), D510.2 (A), D511.2 (A), D512.2 (A)

Notes on the sheet:
LED MATRIX 8(8X8 LEDs)
