garvita4/lightcube/PCB/components.kicad_sch

## KiCad design PCB/components.kicad_sch (2026-11-04)

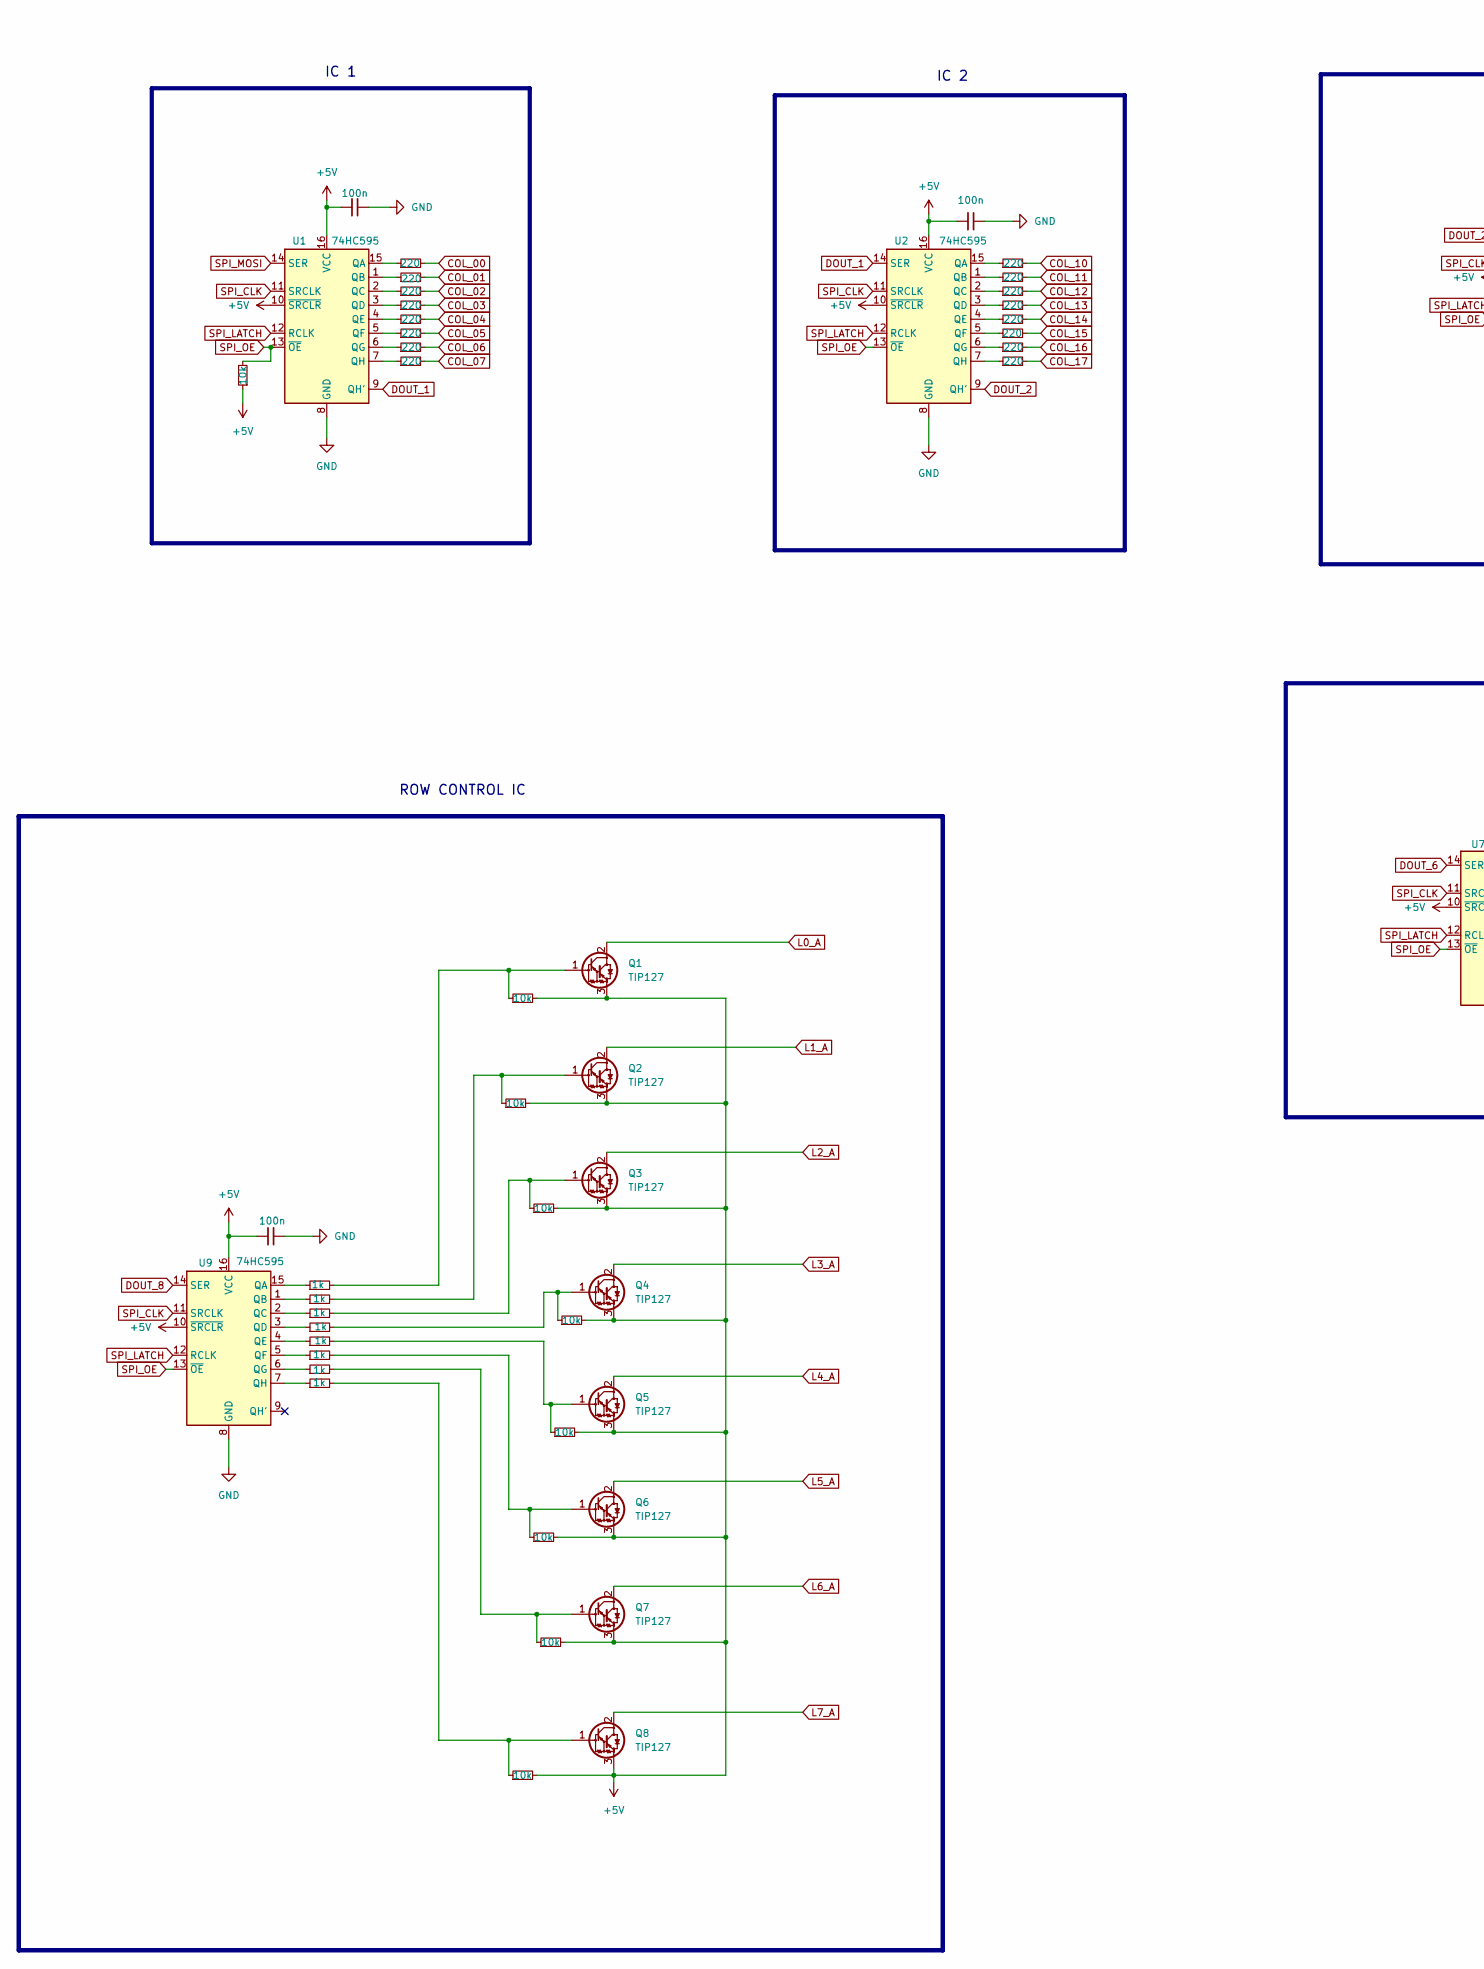
[picture p27: schematic components.kicad_sch, part in row 1, column 1]

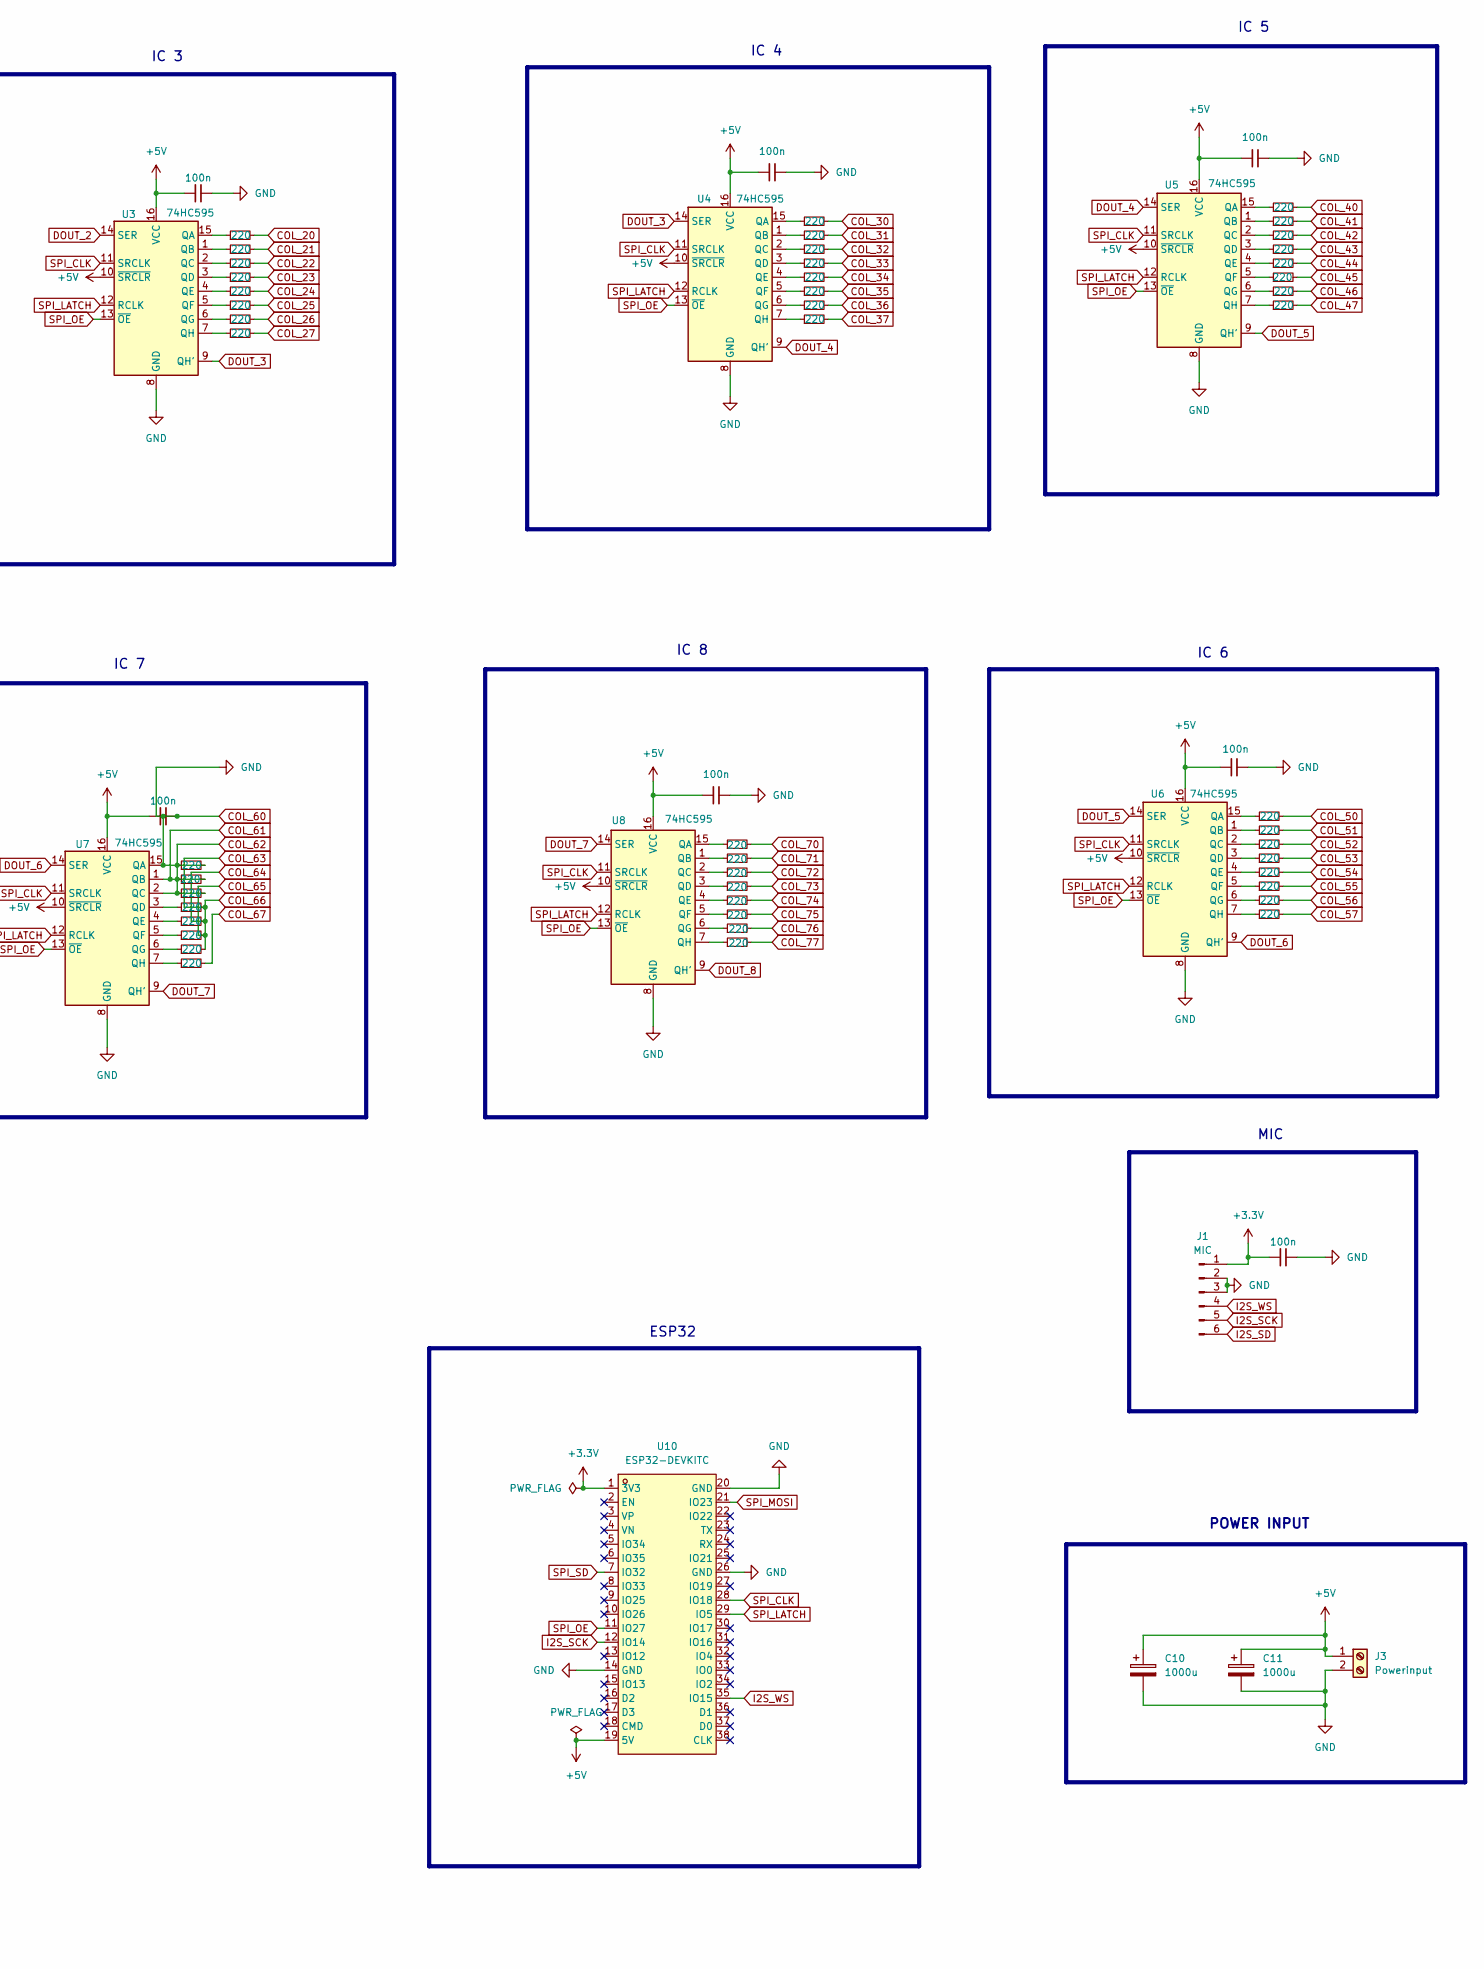
[picture p28: schematic components.kicad_sch, part in row 1, column 2]

Parts:
C1, C2, C3, C4, C5, C6, C7, C8, C9: 100n
C10, C11: 1000u
C12: 100n; Xilinx_CSG48_7.0x7.0mm_Layout7x7_P0.8mm
J1: MIC; DIP-20_W7.62mm
J3: Powerinput
Q1, Q2, Q3, Q4, Q5, Q6, Q7, Q8: TIP127; TO-220-3_Vertical
R1, R2, R3, R4, R5, R6, R7, R8, R9, R10, R11, R12, R13, R14, R15, R16, R17, R18, R19, R20, R21, R22, R23, R24, R25, R26, R27, R28, R29, R30, R31, R32, R33, R34, R35, R36, R37, R38, R39, R40, R41, R42, R43, R44, R45, R46, R47, R48, R49, R50, R51, R52, R53, R54, R55, R56, R57, R58, R59, R60, R61, R62, R63, R64: 220; R_Array_SIP4
R65, R66, R67, R68, R69, R70, R71, R72: 1k; R_Array_SIP4
R73, R74, R75, R76, R77, R78, R79, R80, R81: 10k
U1, U2, U3, U4, U5, U6, U7, U8, U9: 74HC595
U10: ESP32-DEVKITC; BULETM-SMD_ESP32-DEVKITC; MPN ESP32-DevKitC; LCSC Part C571180

Connections:
+3.3V: C12.1, J1.1, U10.1 (3V3)
+5V: C1.1, C2.1, C3.1, C4.1, C5.1, C6.1, C7.1, C8.1, C9.1, C10.1, C11.1, J3.1, Q1.3 (E), Q2.3 (E), Q3.3 (E), Q4.3 (E), Q5.3 (E), Q6.3 (E), Q7.3 (E), Q8.3 (E), R73.2, R74.1, R75.2, R76.2, R77.2, R78.2, R79.2, R80.2, R81.2, U1.10 (~SRCLR), U1.16 (VCC), U2.10 (~SRCLR), U2.16 (VCC), U3.10 (~SRCLR), U3.16 (VCC), U4.10 (~SRCLR), U4.16 (VCC), U5.10 (~SRCLR), U5.16 (VCC), U6.10 (~SRCLR), U6.16 (VCC), U7.10 (~SRCLR), U7.16 (VCC), U8.10 (~SRCLR), U8.16 (VCC), U9.10 (~SRCLR), U9.16 (VCC), U10.19 (5V)
COL_00: R8.2
COL_01: R7.2
COL_02: R4.2
COL_03: R6.2
COL_04: R5.2
COL_05: R3.2
COL_06: R2.2
COL_07: R1.2
COL_10: R9.2
COL_11: R10.2
COL_12: R14.2
COL_13: R15.2
COL_14: R13.2
COL_15: R16.2
COL_16: R12.2
COL_17: R11.2
COL_20: R17.2
COL_21: R24.2
COL_22: R23.2
COL_23: R22.2
COL_24: R18.2
COL_25: R19.2
COL_26: R20.2
COL_27: R21.2
COL_30: R32.2
COL_31: R31.2
COL_32: R30.2
COL_33: R29.2
COL_34: R28.2
COL_35: R27.2
COL_36: R26.2
COL_37: R25.2
COL_40: R34.2
COL_41: R35.2
COL_42: R36.2
COL_43: R37.2
COL_44: R38.2
COL_45: R39.2
COL_46: R40.2
COL_47: R33.2
COL_50: R42.2
COL_51: R43.2
COL_52: R44.2
COL_53: R45.2
COL_54: R46.2
COL_55: R47.2
COL_56: R48.2
COL_57: R41.2
COL_60: C1.2, C2.2, C3.2, C4.2, C5.2, C6.2, C7.2, C8.2, C9.2, C10.2, C11.2, C12.2, J1.2, J1.3, J3.2, R54.1, R54.2, R55.1, R55.2, R56.1, R56.2, U1.8 (GND), U2.8 (GND), U3.8 (GND), U4.8 (GND), U5.8 (GND), U6.8 (GND), U7.1 (QB), U7.2 (QC), U7.8 (GND), U7.15 (QA), U8.8 (GND), U9.8 (GND), U10.14 (GND), U10.20 (GND), U10.26 (GND)
COL_63: R50.2, R51.2, R52.2, R53.2
COL_67: R49.2
COL_70: R58.2
COL_71: R59.2
COL_72: R60.2
COL_73: R61.2
COL_74: R62.2
COL_75: R63.2
COL_76: R64.2
COL_77: R57.2
DOUT_1: U1.9 (QH'), U2.14 (SER)
DOUT_2: U2.9 (QH'), U3.14 (SER)
DOUT_3: U3.9 (QH'), U4.14 (SER)
DOUT_4: U4.9 (QH'), U5.14 (SER)
DOUT_5: U5.9 (QH'), U6.14 (SER)
DOUT_6: U6.9 (QH'), U7.14 (SER)
DOUT_7: U7.9 (QH'), U8.14 (SER)
DOUT_8: U8.9 (QH'), U9.14 (SER)
I2S_SCK: J1.5, U10.12 (IO14)
I2S_SD: J1.6
I2S_WS: J1.4, U10.35 (IO15)
L0_A: Q1.2 (C)
L1_A: Q2.2 (C)
L2_A: Q3.2 (C)
L3_A: Q4.2 (C)
L4_A: Q5.2 (C)
L5_A: Q6.2 (C)
L6_A: Q7.2 (C)
L7_A: Q8.2 (C)
unnamed: Q1.1 (B), R72.2, R73.1
unnamed: Q2.1 (B), R71.2, R81.1
unnamed: Q3.1 (B), R70.2, R80.1
unnamed: Q4.1 (B), R69.2, R79.1
unnamed: Q5.1 (B), R68.2, R78.1
unnamed: Q6.1 (B), R67.2, R77.1
unnamed: Q7.1 (B), R66.2, R76.1
unnamed: Q8.1 (B), R65.2, R75.1
unnamed: R1.1, U1.7 (QH)
unnamed: R2.1, U1.6 (QG)
unnamed: R3.1, U1.5 (QF)
unnamed: R4.1, U1.2 (QC)
unnamed: R5.1, U1.4 (QE)
unnamed: R6.1, U1.3 (QD)
unnamed: R7.1, U1.1 (QB)
unnamed: R8.1, U1.15 (QA)
unnamed: R9.1, U2.15 (QA)
unnamed: R10.1, U2.1 (QB)
unnamed: R11.1, U2.7 (QH)
unnamed: R12.1, U2.6 (QG)
unnamed: R13.1, U2.4 (QE)
unnamed: R14.1, U2.2 (QC)
unnamed: R15.1, U2.3 (QD)
unnamed: R16.1, U2.5 (QF)
unnamed: R17.1, U3.15 (QA)
unnamed: R18.1, U3.4 (QE)
unnamed: R19.1, U3.5 (QF)
unnamed: R20.1, U3.6 (QG)
unnamed: R21.1, U3.7 (QH)
unnamed: R22.1, U3.3 (QD)
unnamed: R23.1, U3.2 (QC)
unnamed: R24.1, U3.1 (QB)
unnamed: R25.1, U4.7 (QH)
unnamed: R26.1, U4.6 (QG)
unnamed: R27.1, U4.5 (QF)
unnamed: R28.1, U4.4 (QE)
unnamed: R29.1, U4.3 (QD)
unnamed: R30.1, U4.2 (QC)
unnamed: R31.1, U4.1 (QB)
unnamed: R32.1, U4.15 (QA)
unnamed: R33.1, U5.7 (QH)
unnamed: R34.1, U5.15 (QA)
unnamed: R35.1, U5.1 (QB)
unnamed: R36.1, U5.2 (QC)
unnamed: R37.1, U5.3 (QD)
unnamed: R38.1, U5.4 (QE)
unnamed: R39.1, U5.5 (QF)
unnamed: R40.1, U5.6 (QG)
unnamed: R41.1, U6.7 (QH)
unnamed: R42.1, U6.15 (QA)
unnamed: R43.1, U6.1 (QB)
unnamed: R44.1, U6.2 (QC)
unnamed: R45.1, U6.3 (QD)
unnamed: R46.1, U6.4 (QE)
unnamed: R47.1, U6.5 (QF)
unnamed: R48.1, U6.6 (QG)
unnamed: R49.1, U7.7 (QH)
unnamed: R50.1, U7.6 (QG)
unnamed: R51.1, U7.3 (QD)
unnamed: R52.1, U7.4 (QE)
unnamed: R53.1, U7.5 (QF)
unnamed: R57.1, U8.7 (QH)
unnamed: R58.1, U8.15 (QA)
unnamed: R59.1, U8.1 (QB)
unnamed: R60.1, U8.2 (QC)
unnamed: R61.1, U8.3 (QD)
unnamed: R62.1, U8.4 (QE)
unnamed: R63.1, U8.5 (QF)
unnamed: R64.1, U8.6 (QG)
unnamed: R65.1, U9.7 (QH)
unnamed: R66.1, U9.6 (QG)
unnamed: R67.1, U9.5 (QF)
unnamed: R68.1, U9.4 (QE)
unnamed: R69.1, U9.3 (QD)
unnamed: R70.1, U9.2 (QC)
unnamed: R71.1, U9.1 (QB)
unnamed: R72.1, U9.15 (QA)
SPI_CLK: U1.11 (SRCLK), U2.11 (SRCLK), U3.11 (SRCLK), U4.11 (SRCLK), U5.11 (SRCLK), U6.11 (SRCLK), U7.11 (SRCLK), U8.11 (SRCLK), U9.11 (SRCLK), U10.28 (IO18)
SPI_LATCH: U1.12 (RCLK), U2.12 (RCLK), U3.12 (RCLK), U4.12 (RCLK), U5.12 (RCLK), U6.12 (RCLK), U7.12 (RCLK), U8.12 (RCLK), U9.12 (RCLK), U10.29 (IO5)
SPI_MOSI: U1.14 (SER), U10.21 (IO23)
SPI_OE: R74.2, U1.13 (~OE), U2.13 (~OE), U3.13 (~OE), U4.13 (~OE), U5.13 (~OE), U6.13 (~OE), U7.13 (~OE), U8.13 (~OE), U9.13 (~OE), U10.11 (IO27)
SPI_SD: U10.7 (IO32)

Notes on the sheet:
ESP32
IC 3
IC 4
IC 2
IC 8
IC 5
IC 7
IC 6
IC 1
MIC
ROW CONTROL IC
POWER INPUT
